arsovskiteodor/A.ProdDeck/KiCAD/ProdDeck/fab/BOM_assembly.csv

Designator | Value | Footprint | Manufacturer | MPN | Qty
BOOT0 | BOOT0 | Button_Switch_SMD:SW_SPST_CK_RS282G05A3 | C&K | RS-282G05A3-SM RT | 1
C1,C3,C5,C6,C10,C19 | 4u7 | Capacitor_SMD:C_0603_1608Metric | KYOCERA AVX | 0603YD475MAT2A | 6
C2 | 1u | Capacitor_SMD:C_0402_1005Metric | KYOCERA AVX | 0402ZD105KAT2A | 1
C4,C7,C8,C9,C11,C12,C13,C14,C15,C18,C22 | 100n | Capacitor_SMD:C_0402_1005Metric | KYOCERA AVX | 04023C104KAT2A | 11
C16,C17 | 10p | Capacitor_SMD:C_0402_1005Metric | KYOCERA AVX | 04025A100JAT4A | 2
C20 | 0p8 | Capacitor_SMD:C_0402_1005Metric | Murata Electronics | GRM1555C1HR80BA01D | 1
C21 | 0p3 | Capacitor_SMD:C_0402_1005Metric | Murata Electronics | GRM1555C1HR30WA01D | 1
D1,D4 | LED | LED_SMD:LED_0402_1005Metric | Wurth Elektronik | 150040RS73240 | 2
D2,D3 | PMEG2010AEH | Diode_SMD:D_SOD-123 | Nexperia | PMEG2010AEH,115 | 2
FLT1 | DLF162500LT-5028A1 | ProdDeck_PCBlib:DLF162500LT-5028A1 | TDK | DLF162500LT-5028A1 | 1
L1 | 10n | Inductor_SMD:L_0402_1005Metric | Murata Electronics | LQG15WZ10NJ02D | 1
L2 | 10u | Inductor_SMD:L_0805_2012Metric | Murata Electronics | LQM21FN100M80L | 1
L3 | 2n7 | Inductor_SMD:L_0402_1005Metric | Murata Electronics | LQG15HS2N7S02D | 1
NRST1 | NRST | Button_Switch_SMD:SW_SPST_CK_RS282G05A3 | C&K | RS-282G05A3-SM RT | 1
R1,R2,R3,R4,R10 | 5k1 | Resistor_SMD:R_0402_1005Metric | YAGEO | RC0402FR-075K1L | 5
R7 | 1k | Resistor_SMD:R_0402_1005Metric | YAGEO | RC0402FR-071KL | 1
R8,R9 | 100k | Resistor_SMD:R_0402_1005Metric | YAGEO | RC0402FR-07100KL | 2
R11 | 220R | Resistor_SMD:R_0402_1005Metric | YAGEO | RC0402FR-07221RL | 1
RF1 | Conn_Coaxial | Connector_Coaxial:U.FL_Hirose_U.FL-R-SMT-1_Vertical | Hirose Connector | U.FL-R-SMT(01) | 1
U1 | MIC5365-3.3YD5 | Package_TO_SOT_SMD:TSOT-23-5 | Microchip Technology | MIC5365-3.3YD5-TR | 1
U2 | USBLC6-2SC6 | Package_TO_SOT_SMD:SOT-23-6 | STMicroelectronics | USBLC6-2SC6 | 1
U3 | MCP73831-2-OT | Package_TO_SOT_SMD:SOT-23-5 | Microchip Technology | MCP73831T-2ACI/OT | 1
U4 | STM32WB55CGU6 | Package_DFN_QFN:QFN-48-1EP_7x7mm_P0.5mm_EP5.6x5.6mm | STMicroelectronics | STM32WB55CGU6 | 1
USB1 | USB_C_Receptacle_USB2.0_16P | Connector_USB:USB_C_Receptacle_GCT_USB4105-xx-A_16P_TopMnt_Horizontal | GCT | USB4105-GF-A | 1
X1 | 32kHz768 | Crystal:Crystal_SMD_2012-2Pin_2.0x1.2mm | NDK (NIHON DEMPA KOGYO CO., LTD) | STDMUB1-32.768K | 1
X2 | 32MHz | Crystal:Crystal_SMD_2016-4Pin_2.0x1.6mm | NDK | NX2016SA-32M-EXS00A-CS06465 | 1
