arsovskiteodor/A.ProdDeck/KiCAD/ProdDeck/test1.step

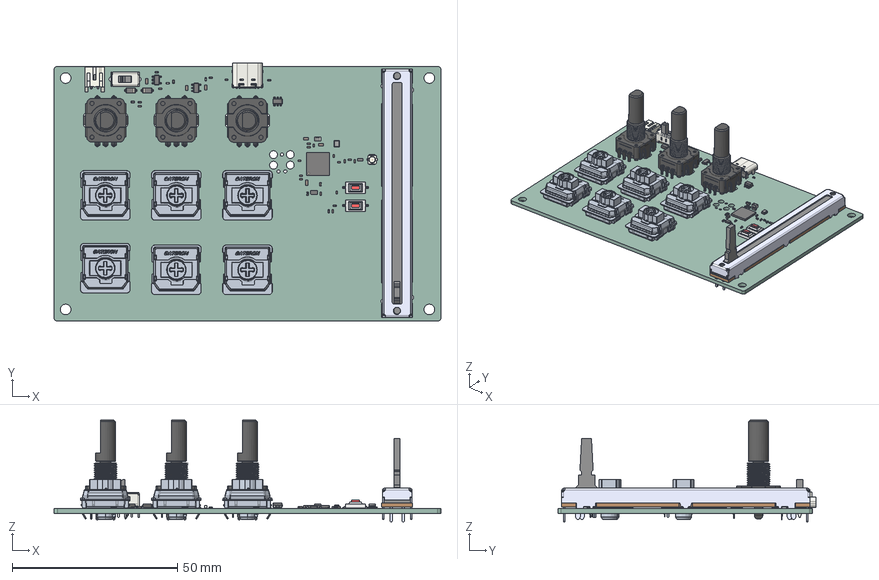
[picture p3: CAD file, 2026-10-11]
KiCAD/ProdDeck/test1.step
117.0 x 78.1 x 30.8 mm
C_0402_1005Metric x 16
PTA6043-2015DPB103
C_0603_1608Metric x 6
R_0402_1005Metric x 9
MicroCrystal_CC8V_T1A
D_SOD-123 x 2
Crystal_SMD_2016-4Pin_2.0x1.6mm
QFN-48-1EP_7x7mm_Pitch0.5mm
RD-014B4CF0776gx x 6
L_0805_2012Metric
LED_0402_1005Metric x 2
L_0402_1005Metric x 2
TSOT-23-5
SW_Slide_SPDT_Straight_CK_OS102011MS2Q
SOT-23-6
USB_C_Receptacle_16P_TopMnt_Horizontal_GCT_USB4105-xx-A
SOT-23-5
SW_SPST_CK_RS282G05A3 x 2
U.FL_Hirose_U.FL-R-SMT-1_Vertical
JST_S2B_PH_K
ProdDeck_PCB
