arsovskiteodor/A.ProdDeck/KiCAD/ProdDeck/DLF-4_1P6X0P8.step

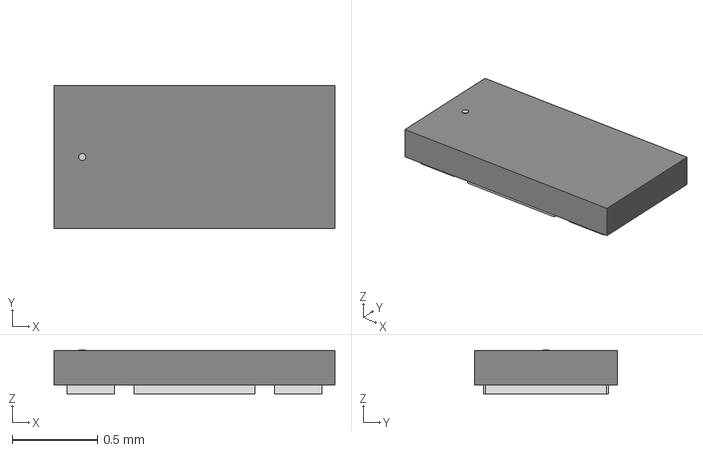
[picture p4: CAD file, 2026-10-11]
KiCAD/ProdDeck/DLF-4_1P6X0P8.step
1.65 x 0.838 x 0.257 mm
