arsovskiteodor/A.ProdDeck/(list of files, cad)

Other CAD files:
KiCAD/ProdDeck/test1.stl
