arsovskiteodor/A.ProdDeck/(commit log)

2026-10-11 pcb done
2026-10-11 Vendor MX_V2 and PEC11R footprint libs as plain folders
